redstoner-35/Xtern-Ripper-Lite/README.md

### 概述

这是由redstoner_35所开发的，基于FlashLightOS-Entry固件所开发的低成本32mm侧按全程降压恒流驱动。这款驱动相比强大的[Xtern-Ripper V3](https://github.com/redstoner-35/Xtern-Ripper)来说更为精简实用，且简化了操作逻辑，更适合于面向圈外人士使用的实用手电。且该驱动为单PCB设计，6mm的最大高度基本可以适配市面上大部分主流手电外壳。

### 关于FlashLightOS-Entry

FlashLightOS-Entry是面向低成本，较低性能的增强型8位8051单片机平台的FlashLightOS实现。相比运行在ARM平台的标准版FlashLightOS进行了更进一步的逻辑调整和优化降低性能和代码开销。该实现相比标准版FlashLightOS移除了几乎所有的挡位自定义和运行状态记录的功能，挡位逻辑硬编码于单片机的ROM内不可调整，也不需要外挂EEPROM作为系统的数据存储器。这使得该固件可以运行在32-48MHz主频的增强型8051单片机上，并且通过单片机片内EEPROM完成少量数据的存储从而最大限度的简化了驱动数字域部分的电路设计。

与此同时，得益于中微8bit平台的灵活性（数字IO可任意重映射）以及快速启动，本固件可进一步扩展为双模式尾按/侧按手电的版本，且外围电路可根据需要任意调整从而实现多种拓扑（单锂电升压/BUCK/4BB等）从而使得驱动使用可以更灵活。

### 驱动硬件结构

该驱动为了节约成本使用了现成的DC-DC芯片，并通过基于运放的外部恒流环路根据通过的LED电流，动态的调整DCDC芯片反馈引脚的电位从而调节输出电压实现恒流。对于LED辉度的控制，MCU则通过PWM+二阶RC滤波的方式为恒流环路提供设置输出电流的参考电压使LED运行在目标电流。与此同时，为了解决在低输出电流下检流部分的信噪比不足导致低亮度抖动，因此本驱动加入了LED电流的切换开关根据输出电流的范围动态选择电流通过的检流电阻确保在整个挡位的选择范围内信噪比足够。

### 工程结构

该工程一共有3个文件夹，分别对应2套PCB。文件格式为Altium Designer 15。可以用LCEDA导入后转换为LCEDA格式以便查看BOM和位号。各个PCB作用如下：

+ MainPCB：这个文件夹包含驱动的主板。
+ SideKeyPCB：这个文件夹包含配套使用的LED侧按按键板，通过细排线连接到驱动上层的子板。侧按板直径12mm，适配东东海D8B外壳。
+ Firmware：这个文件夹包含驱动的固件源代码

### PCB打样注意事项

+ `MainPCB`：1.6mm 4层板，默认层叠顺序（Top GND VCC Bottom）必须过孔塞树脂+沉金。内层必须加厚为1Oz，有条件建议上四层2Oz。
+ `SideKeyPCB`:1.0mm厚度双面板，铜厚1Oz喷锡即可。

### 调试说明

该驱动的设计为免调试的。只需要按照PCB上的丝印、器件位置和BOM表焊接好所有器件并为单片机刷入附带的[程序文件](/MainPCB/Firmware.hex)即可使用，不需要任何调试工作。对于驱动的成品图片可以参考下方：
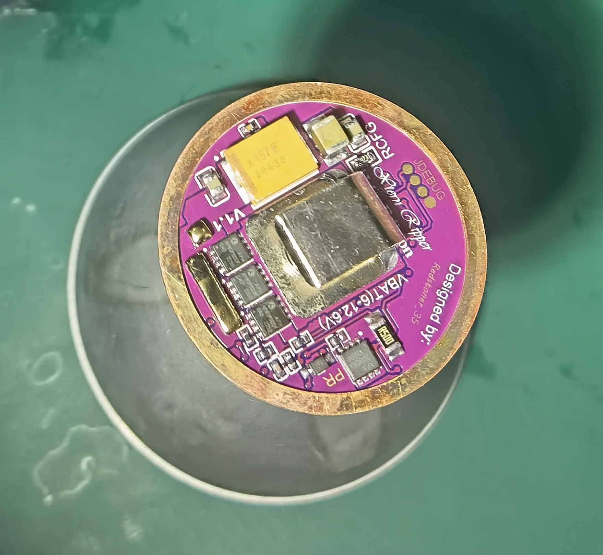
[picture p1: 成品图片/1.jpg]
背面

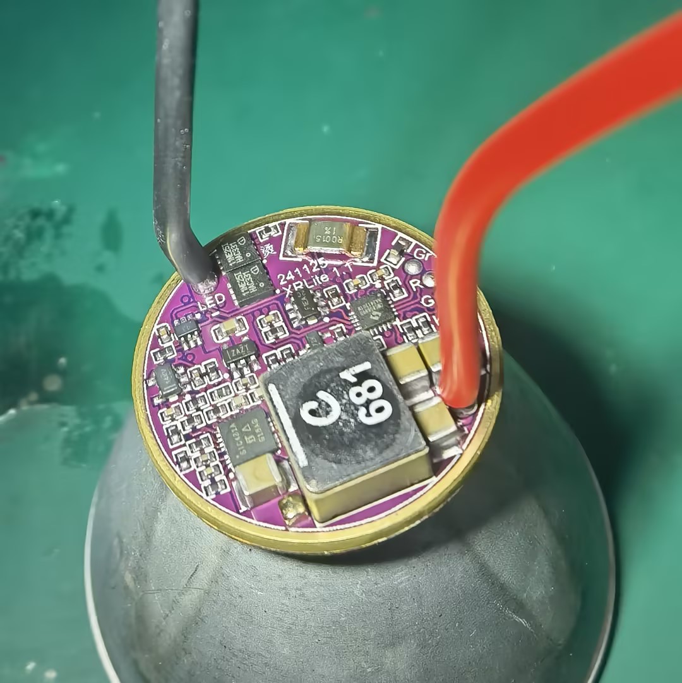
[picture p2: 成品图片/2.jpg]
正面


对于背面的装筒效果则如下图所示：

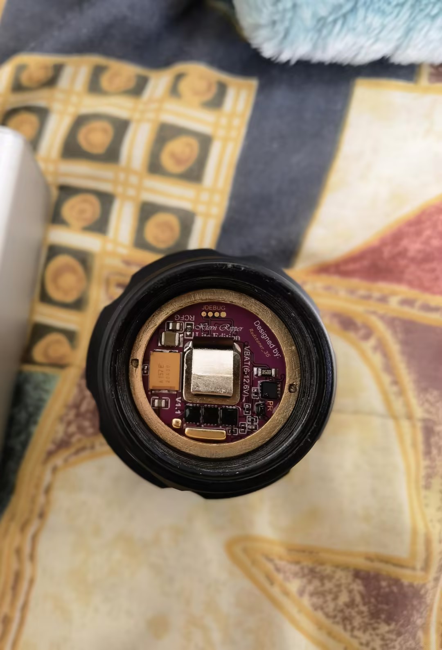
[picture p3: 成品图片/3.jpg]
装筒后背面


需要注意的是，如果您计划将该驱动用于仅具备侧部电子开关的外壳并且使用高内阻的容量型电池，则默认的固件程序因为内置的尾按监测机制会在爆闪等高瞬态的场合因电池内阻过大导致电压跌落至尾按监测阈值，引起爆闪SOS等挡位无法正常运行或者出现自动跳档。此时您需要刷入[禁用尾按监测功能的程序文件](/MainPCB/Firmware-ESwitch.hex)以解决部分挡位无法使用或者莫名其妙失控自动换挡等bug，此时配置电阻中关于尾按开关类型的设置机制将会被无视。

### 配置电阻设置

在V1.1版本中，驱动背面新增了一个标注为RCFG的0603电阻（见下图所示位置），用于配置驱动所支持的LED类型，极亮电流和电池串数，以及尾按开关的类型。驱动在每次上电时会自动读取该电阻的阻值并根据阻值设定参数。
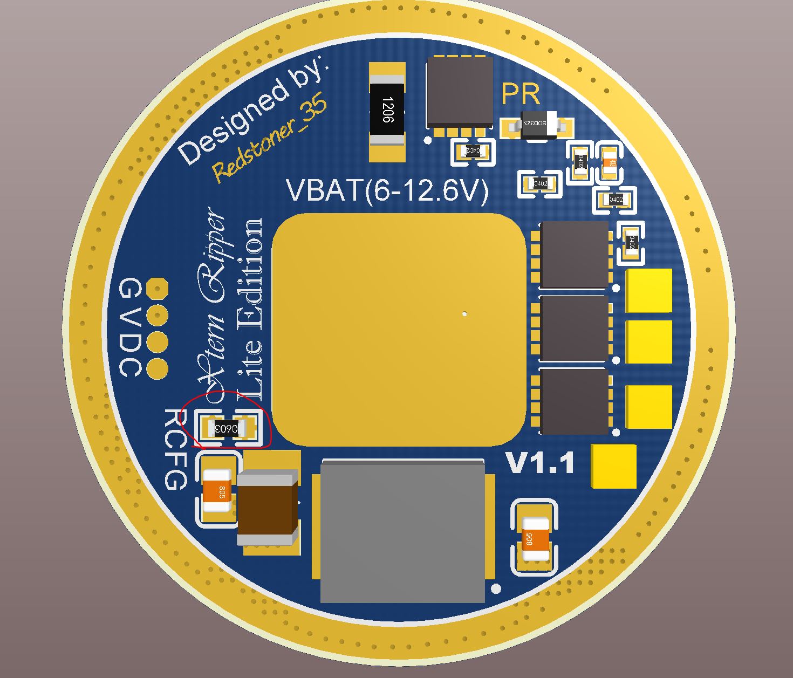
[picture p4: 成品图片/4.JPG]
配置电阻位置


#### 正向开关和反向机械尾按开关的区别

反向机械尾按开关和正向机械尾按开关适合于不同的用途，正向机械开关因为可以瞬时点亮的特性，更适合用于战术用途，但换挡操作较为不便。反向机械开关的换挡则更为方便但是缺乏正向机械开关的战术功能性，不支持无声点射（战术正向开关轻按点亮时不会发出声音）。这两者的区别如下：

+ 反向机械开关：关闭状态下需要重按到底发出咔哒声并松手后才能接通电路，处于开启状态下轻按开关则电路断开，松手后立马接通。如果再次重按到底发出咔哒声并松手则后开关断开，此时开关回到关闭状态。
+ 正向机械开关：关闭状态下轻按开关时即可接通电路，松手后立即断开。如果重按开关到底发出咔哒声后则电路保持接通（即使松手也不会断开）此时轻按开关电路仍然保持接通，只有再次重按到底发出咔哒声并松手后电路才会断开并回到关闭状态。

**注意：请严格按照使用的尾按类型选择配置电阻。如果配置电阻和尾按开关类型不匹配，则会出现开机存在延迟、尾按无法换挡或驱动工作异常等问题！如果您将本驱动用于没有尾部机械开关、只有侧部电子开关的场合，则请将驱动配置为反向机械开关的模式。**

#### 电阻阻值选择

**反向机械开关**

+ 182K：3串3.7V三元锂输入，6V LED，极亮14.5A（适用于DFEx-SuperLED+ QV7007I Gen1）
+ 174K：3串3.7V三元锂输入，6V LED，极亮18A（适用于DFEx-SuperLED+ FI1048D Gen1）
+ 168K：3串3.7V三元锂输入，6V LED，极亮10A（适用于SFQ75.3-6V or CREE XHP70.2 or CREE XHP70.3HI/HD）
+ 154K：3串3.7V三元锂输入，3V LED，极亮23A（适用于Luminus SBT90.2 or NBT160.2 or SFQ75.3）
+ 147K：2串3.7V三元锂输入，3V LED，极亮23A（适用于Luminus SBT90.2 or NBT160.2 or SFQ75.3）
+ 133K：2串3.7V三元锂输入，3V LED，极亮12A（适用于N5-235HP或者老批次SFT40 N5145冲刺极限光强）
+ 124K：2串3.7V三元锂输入，3V LED，极亮18A（适用于Luminus SBT90.2标准使用不超功率）
+ 113K：2串3.7V三元锂输入，3V LED，极亮10A（适用于N5-235HP标准使用不超功率）

**正向机械开关**

+ 82K：3串3.7V三元锂输入，6V LED，极亮14.5A（适用于DFEx-SuperLED+ QV7007I Gen1）
+ 75K：3串3.7V三元锂输入，6V LED，极亮18A（适用于DFEx-SuperLED+ FI1048D Gen1）
+ 68K：3串3.7V三元锂输入，6V LED，极亮10A（适用于SFQ75.3-6V or CREE XHP70.2 or CREE XHP70.3HI/HD）
+ 56K：3串3.7V三元锂输入，3V LED，极亮23A（适用于Luminus SBT90.2 or NBT160.2 or SFQ75.3）
+ 47K：2串3.7V三元锂输入，3V LED，极亮23A（适用于Luminus SBT90.2 or NBT160.2 or SFQ75.3）
+ 33K：2串3.7V三元锂输入，3V LED，极亮12A（适用于N5-235HP或者老批次SFT40 N5145冲刺极限光强）
+ 24K：2串3.7V三元锂输入，3V LED，极亮18A（适用于Luminus SBT90.2标准使用不超功率）
+ 15K：2串3.7V三元锂输入，3V LED，极亮10A（适用于N5-235HP标准使用不超功率）

**需要特别注意的是，配置电阻不能开路和短路，阻值需要在10K至200K之间并且按表选择，为了确保系统能正确识别配置，请选择至少1%精度并且温飘在50PPM以下的0603精密电阻作为配置电阻。如果该电阻阻值不合适或者空焊，驱动将会拒绝启动并报错。为了避免驱动的低电压保护失效引起电池损坏或者错误的提示LED发生故障，请严格按照实际的硬件情况选取该配置电阻的阻值。**

### 侧按换挡和配置操作逻辑

该驱动具备无极调光和传统挡位模式两种逻辑供用户自由选择：
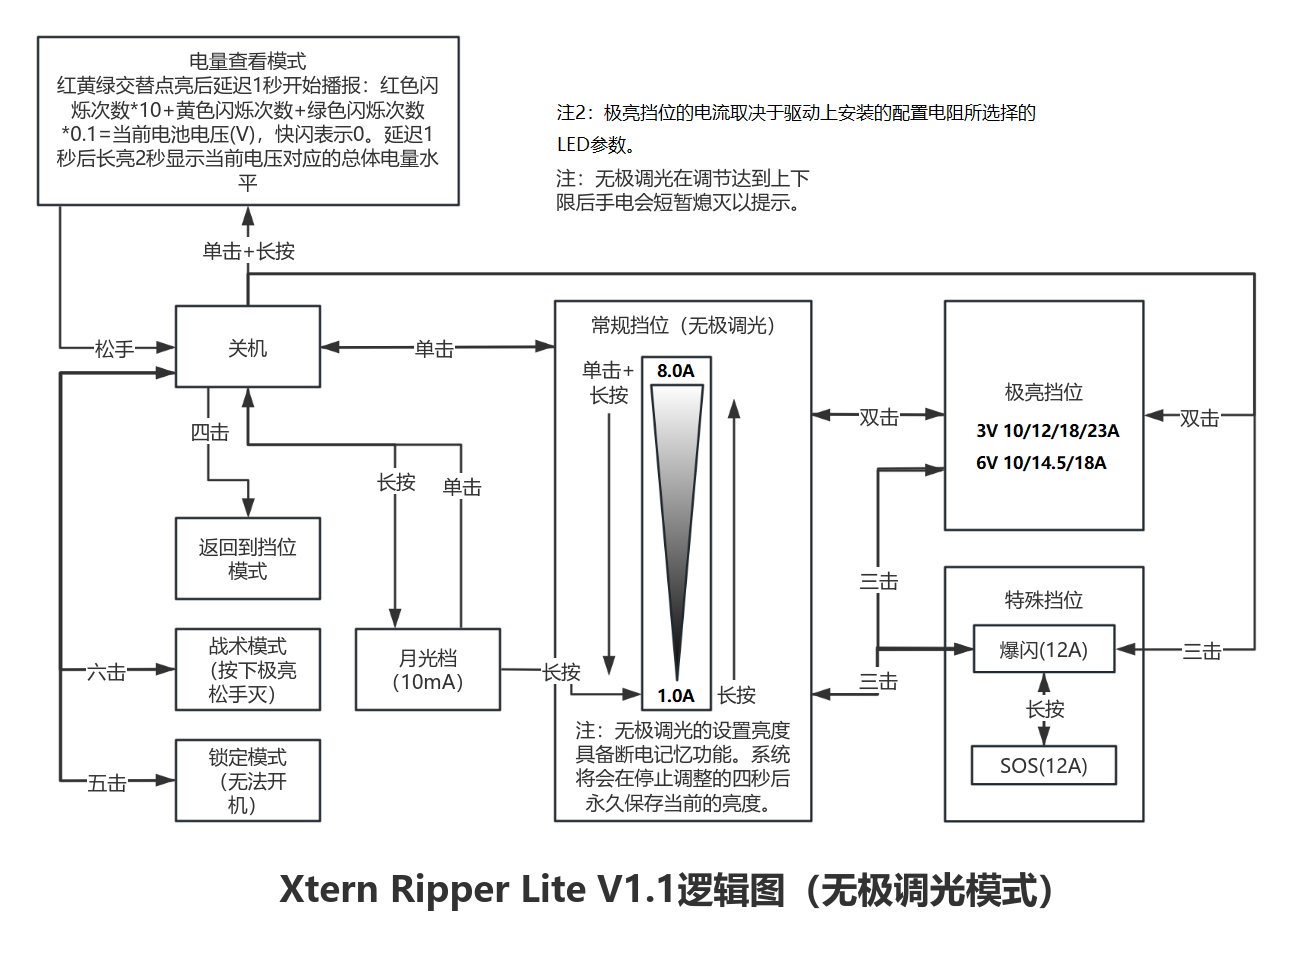
[picture p5: 成品图片/Ramp.png]
无极调光

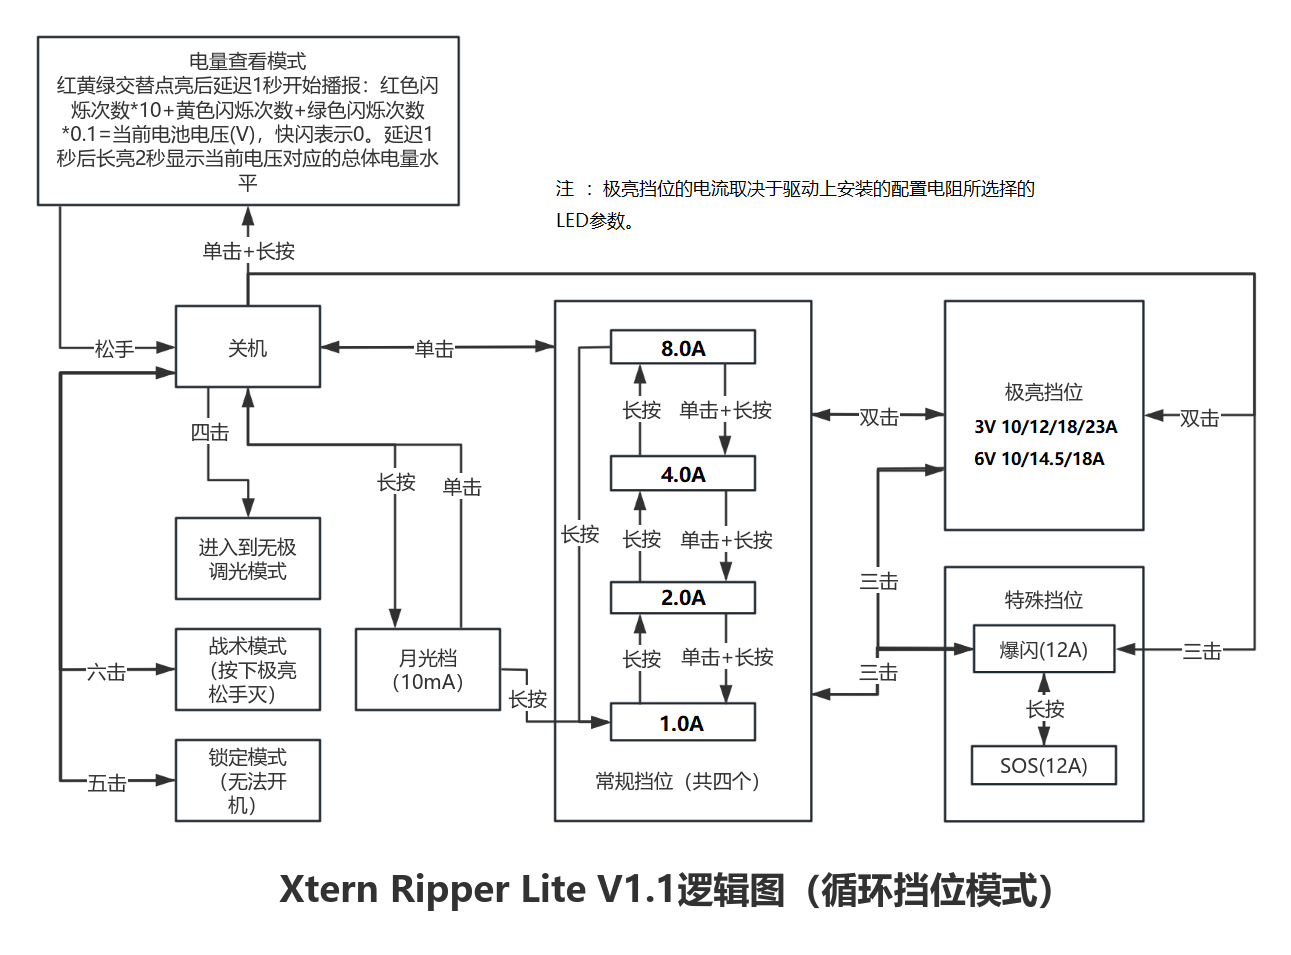
[picture p6: 成品图片/Mode.png]
挡位模式


需要补充的是，图中的任意挡位均可以通过单击立即回到关闭状态。对于图中的部分未详尽解释的特殊逻辑，则可参考如下内容：

+ 切换无极调光和挡位模式：关机状态下四击开关，此时开关指示灯将会闪烁三次。如果闪烁颜色为红色则无极调光已被关闭，绿色则为开启。
+ 战术模式：关机状态下六击开关，手电主灯迅速频闪一次表示进入战术模式。默认情况下战术功能为按下开关手电以极亮运行，松开则熄灭。当手电进入战术模式后，侧部按键将会每2秒快闪一次指示当前处于战术模式，此时手电将会保持唤醒，直到无操作10分钟后自动进入休眠并退出战术模式。与此同时，您可以通过双击侧按切换战术模式的功能，切换后的指示如下：
    + 一键极亮模式（默认）：此时手电按下开关极亮，松开灭，侧按指示灯每2秒闪1次，切换到该模式时手电的侧按会用红色快闪3次做提示。
    + 一键爆闪模式：此时手电按下开关进入爆闪，松开灭，侧按指示灯每2秒闪2次，切换到该模式时手电的侧按会用绿色快闪3次做提示。
如果您需要主动退出战术模式，则您可再度六击开关，手电主灯频闪一次指示退出战术模式。
+ 按键锁：关机状态下五击开关，手电主灯点亮0.5秒表示进入锁定模式，此时除五击解锁外的任何操作均被忽略。
+ 查询电量：进入操作和逻辑中的一致（如果手电处于开机状态，则通过双击+长按进入）。当进入电量查询模式后手电首先以红黄绿依次点亮的方式提示用户即将显示电量。如果电池电压在合法范围内，则在延迟1秒后手电将通过红色，黄色和绿色的指定次数闪烁提示用户当前的电池电压。如果电池电压超出显示范围（例如2串模式的驱动意外接入3串的锂电池组）则驱动会通过三次红色闪烁提示电压非法。对于电池电压的显示方式则会根据驱动的配置电阻所指定的电池串数自动选择。如果驱动配置为三串输入的时候，系统的显示方式将会被设置为99.9V模式，2串模式则驱动会自动配置为9.99V模式显示以提高电压显示精度。对于电压显示的计算方式请参考如下内容：
    + 99.9V显示模式：红色闪烁次数x10+黄色闪烁次数+绿色闪烁次数x0.1=当前电池电压(V)，例如`红色慢闪1次-黄色快闪一次-绿色慢闪4次`表示电池电压为10x1+0+4x0.1=10.4V。
    + 9.99V显示模式：红色闪烁次数+黄色闪烁次数*0.1+绿色闪烁次数x0.01=当前电池电压(V)，例如`红色慢闪8次-黄色快闪一次-绿色慢闪4次`表示电池电压为8+0x0.1+4x0.01=8.04V。

**注：以上内容中的慢闪指的是持续0.5秒的点亮和持续0.5秒的熄灭交替循环的过程。快闪则是瞬间点亮20mS后熄灭（人眼视觉效果为非常迅速的跳一下）**

播报完电池当前电压后，手电将会在延迟2秒后通过后续的长亮(或者慢闪)提示用户当前电池电压对应的总体电量水平（指示方式参考下文中驱动位于运行状态时的指示）

对于电压指示，驱动在工作状态会通过指示灯点亮的方式提示用户当前系统的电池电量。与此同时，在手电首次装入电池时，驱动还会通过多次黄色快速闪烁指示用户通过配置电阻设置的电池串数（如果闪烁2次则驱动为2串模式，闪烁3次则为三串模式）并且在电池数量指示结束后用一次持续2秒的点亮提示电池电量（指示方式和工作状态时相同）。对于手电当前的电量状态和对应的指示灯状态请参考如下内容：

+ 绿色常亮：电池电量充足
+ 黄色常亮：电池电量较为充足
+ 红色常亮：电池电量不足，请尽快为手电充电
+ 红色慢闪：电池电量严重不足，请立即为手电充电（此时手电的可用挡位和功能将会被限制）

### 错误指示系统

该驱动继承了Xtern Ripper PRO版本的特性，依然具备先进的状态监测系统。在驱动每次通电自检和正常运行过程中，固件会通过ADC采集驱动的运行状态并判断负载和驱动是否运行正常。并且在检测到异常时立即切断驱动输出以避免驱动和被驱动的灯珠损坏。

#### 运行时错误监测和错误ID汇报

在运行期间如果驱动检测到无法解决的致命问题则会进入保护模式避免驱动和灯珠损毁，并通过颈部侧按键的指示灯提示用户发生的错误类型。每个指示循环首先以红黄绿的颜色切换闪烁开始，然后通过紧跟着的红色慢闪次数指示错误ID号，慢闪结束后会停顿一会并重新开始循环，对于ID号所对应的错误描述请参考如下内容：

+ 闪烁1次(Fault_DCDCFailedToStart) 驱动在上电自检尝试启动DCDC时失败。检查驱动输出正极是否对外壳短路，DCDC芯片的使能信号和内部LDO输出电压是否正常。
+ 闪烁2次(Fault_DCDCENOOC) 驱动在上电自检时无法关闭DCDC。检查单片机控制DCDC EN电源的输出是否能正确关闭，EN是否受控。
+ 闪烁3次(Fault_DCDCShort) 驱动在运行时检测到输出短路。
+ 闪烁4次(Fault_InputOVP) 驱动检测到输入电压过高，请检测驱动的电池配置是否和使用的电池配套。
+ 闪烁5次(Fault_DCDCOpen) 驱动在运行时检测到输出空载，检查LED是否损坏。
+ 闪烁6次(Fault_NTCFailed) 驱动在运行期间检测到测量驱动温度的热敏电阻出现异常，检查热敏电阻和测温部分的上拉电阻是否损坏。
+ 闪烁7次(Fault_OverHeat) 驱动检测到外壳温度过高，请等待手电冷却。冷却后故障会自动解除
+ 闪烁8次(Fault_StrapResistorError) 驱动检测到配置电阻未焊接（开路）或阻值过低。请按照配置电阻设置的章节正确焊接电阻并检查电阻是否损坏。
+ 闪烁9次(Fault_StrapMismatch) 配置电阻所指定的LED类型和驱动实际检测到的类型不符，请按照配置电阻设置的章节正确选取阻值。

### 尾按换挡操作逻辑

对于使用东东海D4GC-M4A-D5E等外壳的用户，本驱动提供了双模式换挡固件供用户尝试。该固件除了支持原版固件通过颈部电子开关换挡的功能以外，还支持使用手电外壳的尾部机械开关通过断电的方式进行快捷换挡。同时该固件可支持正向机械尾按开关实现战术点射（需要通过配置电阻选择），换挡方式如下：

#### 反向开关操作逻辑

**特别注意：如果用户通过侧部开关令手电进入关闭状态，则尾部开关换挡功能将被禁用。此时按压尾部开关则无法换挡**

+ 手电开启且处于传统挡位模式下，用户轻按尾按后手电按照从低到高(`1A->2A->4A->8A->->月光->1A...`)再回到月光并从低亮开始反复循环的方式换挡，快速轻按2次则进入极亮档，快速轻按3次则进入爆闪挡位，单击在SOS和爆闪挡位之间循环。如果需要关机，则重按尾按到底听到咔哒声后松手即可关闭。通过尾按关闭手电后下次再重按尾按打开手电后，手电会回到上次关闭之前的挡位继续运行（如果上次关机前挡位为特殊挡位则会回到低亮档）
+ 手电开启且处于无极调光模式下，用户可通过轻按尾按一次进行亮度调整。轻按尾按后手电亮度将会开始从低到高，再到低亮反复变化。当手电亮度达到您的需求后，再次轻按尾按后手电将会保存亮度。快速轻按2次则进入极亮档，快速轻按3次则进入爆闪挡位，单击在SOS和爆闪挡位之间循环，在非爆闪/极亮和SOS等特殊挡位下，快速轻按4次则进入月光档。如果需要关机，则重按尾按到底听到咔哒声后松手即可关闭。通过尾按关闭手电后下次再重按尾按打开手电后，手电会回到上次关闭之前的亮度继续运行（如果上次关机前挡位为特殊挡位则会回到常亮挡位）

#### 正向开关操作逻辑

**对于正向开关而言，操作逻辑中所说的轻按为半按开关至手电上电。重按则是直接按到底进入锁定发出咔哒声。对于操作逻辑中的轻按开关一下指按下开关一瞬间，然后立即放开。**

+ 强制打开通过侧按按键关闭的手电：轻按尾按开关一下并按到底，手电将直接开机。
+ 点射：轻按尾按开关按照上次关机前记忆的挡位（或者无极调光模式下记忆的亮度）点亮，松开熄灭
+ 挡位模式选择下一个挡位：轻按尾按开关一下再轻按并保持，此时手电将会点亮。当手电点亮3秒后记忆当前挡位，此时您可以放开开关以关闭手电，下次轻按开关点射时将会按照您设定的亮度点亮。如果您需要继续换挡，则在保持3秒后放开尾按开关并重复本操作。对于换挡流程，手电则按照从低到高(`1A->2A->4A->8A->->月光->1A...`)再回到月光并从低亮开始反复循环的方式换挡。
+ 无极调光模式下调节亮度：轻按尾按开关一下再轻按并保持。此时手电将会点亮并且亮度再无极调光上限和下限之间反复循环，当手电达到你满意的亮度后松开开关并再次重按到底此时手电将会保存您所选择的亮度，此时您可以再次重按开关以关闭手电，下次轻按开关点射时将会按照您设定的亮度点亮。
+ 快速进入极亮：轻按尾按开关两次后再持续轻按（如果您需要松手后持续点亮则重按开关），手电立即以极亮模式点亮。开关松手后熄灭（注意：极亮模式没有记忆，下次轻按尾按打开手电后会返回低亮档）。
+ 快速进入爆闪：轻按尾按开关三次后再持续保持轻按（如果您需要松手后持续点亮则重按开关），手电立即以爆闪模式点亮。开关松手后熄灭（注意：爆闪模式没有记忆，下次轻按尾按打开手电后会返回低亮档）。
+ 进入SOS模式：轻按尾按开关三次后再持续保持轻按，此时手电将点亮并以爆闪模式工作。在手电进入爆闪模式开始工作时的1秒后，松开手电开关并在瞬间再次重按到底，此时手电进入SOS模式（注意：SOS模式没有记忆，关闭手电后，下次轻按尾按打开手电后会返回低亮档）
+ 无级调光模式下进入月光档：轻按尾按开关四次后再持续保持轻按（如果您需要松手后持续点亮则重按开关），手电点亮并以月光模式运行。

### 固件编译注意事项

#### MCU的CONFIG配置

由于中微单片机内部有一组硬编码于Flash指定区域，用于设置单片机的硬件首选项（例如看门狗，调试模式，低电压保护点等）的配置Word。为了确保编译出来的固件可以在硬件内正常运行，您需要在工程配置(Options for Target 'XRLite'->Debug选项卡->右上角的Settings按钮)的Config设置菜单，按照下表正确填写MCU的配置。错误的CONFIG设置会引起固件工作异常！

+ Power                      :  Inter 5V            
+ WDT                        :  SOFTWARECONTROL     
+ PROTECT                    :  ENABLE              
+ FLASH_DATA_PROTECT         :  ENABLE              
+ LVR                        :  1.8V                
+ DEBUG                      :  Disable             
+ OSC                        :  HSI                 
+ OSC_PRESCALE               :  Fosc/1              
+ HSI_FS                     :  Fhsi/1              
+ EXT_RESET                  :  DISABLE             
+ EXT_RESETSEL               :  P00                 
+ WAKEUP_WAITTIME            :  100us               
+ CPU_WAITCLOCK              :  1T                  
+ WRITE_PROTECT[0-2K]        :  DISABLE             
+ WRITE_PROTECT[2-4K]        :  DISABLE             
+ WRITE_PROTECT[4-6K]        :  DISABLE             
+ WRITE_PROTECT[6-8K]        :  DISABLE             
+ WRITE_PROTECT[8-10K]       :  DISABLE             
+ WRITE_PROTECT[10-12K]      :  DISABLE             
+ WRITE_PROTECT[12-14K]      :  DISABLE             
+ WRITE_PROTECT[14-16K]      :  DISABLE             
+ BOOT                       :  BOOT_DIS            

#### 代码内非语法错误的提示

为了确保用户不会错误的填写部分关键数值（例如温控系统的配置参数）导致固件行为异常，本固件源码内包含一些条件编译的监测代码用于监测非法数值。如果编译时遇到了非语法错误的输出，可以在这里查询相应的错误并进行修正。

+ `Error 001:Invalid Integral Configuration,Trim Value or time-factor out of range!`: 积分器的时间常数和电流修调值决定了积分器的上限，由于积分器所使用的变量为int 16，其值域为-32767到32767。如果积分器上限超过了值域则会导致数值溢出引起程序异常。此时您需要减小电流修调值和时间常数确保两者之积不大于32000。
+ `Error 002:Invalid Integral Configuration,Trim Value or time-factor must not be zero or less than zero!`: 积分器的时间常数和电流修调值决定了积分器的上限，为了确保积分器能正常运行，积分器的上限值不能为0或者负数，请检查填入的数值是否包含负数和0。
+ `Error 003:Emergency Shutdown Temp must not exceeded 85 Celsius!` : 紧急关机温度太高了，不能超过85度
+ `Error 004:Force Disble Turbo Temp must less than Emergency Shutdown Temp for at least 15 Celsius!` :
+ `Error 005:Force Disble Turbo Temp must higher than Constant Temp of Turbo Mode for at least 8 Celsius!`: 强制禁用极亮挡位的温控值应该比紧急关机温度低15度以上，且至少高于极亮恒温温度8度
+ `Error 006:Constant Temperature of Turbo Mode must lagger than Constant Temperature of other mode!`:
+ `Error 007:Constant Temperature of other mode must lagger than Thermal Control Release Temp for 5 Celsius!`: 非极亮挡位的温控恒温温度必须要比极亮挡位的温控数值小，且至少比温控停止的阈值高5度确保温控的稳定运行。
+ `Error 008:Thermal Control Release Temp is too low and will not release at summer!`: PI环的温控释放点太低，在夏天因为手电自发热可能导致温控始终激活，即使通过外力给手电降温也无法正确退出。

----------------------------------------------------------------------------------------------------------------------------------
© redstoner_35 @ 35's Embedded Systems Inc.  2024
