redstoner-35/Xtern-Ripper-Lite/MainPCB/BOM.xlsx

编号 | 料号 | 描述 | 位号 | 封装 | 数量 | 备注 | 单价 | 总价
1 | TCN4107M035R0100E | 京瓷/AVX 贴片聚合物钽电容器 35V 100uF ±20% 2924 ESR=100mΩ | C1 | TCN4 | 1 | 这玩意单价不便宜，封装特殊小心买到假的。2串三元锂电输入的时候可以TCN4157M025R0070E替代 | 12 | 12
2 | EMK325ABJ107MM-T | 1210尺寸多层陶瓷电容器(MLCC) X5R材质，16V 100uF±20% | C2, C3, C4, C5, C6 | 1210C | 5 | 此处提供的为太诱的料号，可用AVX/村田和国巨的相似参数电容进行替代 | 1.8 | 9
3 | 22uF (226) 20% 25V | 0805贴片电容 | C7, C10 | 0805_C | 2 |  | 0.1 | 0.2
4 | 220nF (224) 10% 16V | 0402贴片电容 | C8 | 0402_C | 1 |  | 0.03 | 0.03
5 | 100nF (104) 10% 16V | 0402贴片电容 | C9, C14, C15, C20 | 0402_C | 4 |  | 0.03 | 0.12
6 | 4.7uF (475) 20% 10V | 0402贴片电容 | C11, C12 | 0402_C | 2 |  | 0.03 | 0.06
7 | 47nF (473) 10% 50V | 0402贴片电容 | C13 | 0402_C | 1 |  | 0.03 | 0.03
8 | 1.0uF (105) 10% 25V | 0402贴片电容 | C16 | 0402_C | 1 |  | 0.03 | 0.03
9 | 10uF (106) 10% 10V | 0402贴片电容 | C17 | 0603_C | 1 |  | 0.03 | 0.03
10 | 10nF (103) 10% 50V | 0402贴片电容 | C18 | 0402_C | 1 |  | 0.03 | 0.03
11 | 470nF (474) 10% 10V | 0402贴片电容 | C19 | 0402_C | 1 |  | 0.03 | 0.03
12 | 1nF (102) 10% 50V | 0402贴片电容 | C21 | 0402_C | 1 |  | 0.03 | 0.03
13 | 1N4148WS T4 | 二极管 | D1 | SOD-323 | 1 |  | 0.08 | 0.08
14 | BZT52C3V9S W5 | SOD-323封装贴片稳压二极管， 3.9V 200mW | D2 | SOD-323 | 1 |  | 0.095 | 0.095
15 | EBMS100505A050 | 贴片磁珠 200mA 5R±25% 100MHz | FB1 | 0402_L | 1 |  | 0.018 | 0.018
16 | XAL1060-681MEB | 线艺XAL系列模压屏蔽贴片电感 680nH±20% 10*10*6mm尺寸 DCR：2.50mΩ 饱和电流43A | L1 | XAL1010-XXXME | 1 |  | 30 | 30
17 | AP80P02DF | 永源微 PDFN3x3-8L -20V -80A 4.0mΩ P沟道MOSFET | Q1, Q2, Q3 | DFN-8_L3.0-W3.0-P0.65-BL | 3 |  | 0.65 | 1.95
18 | BSZ011NE2LS5IATMA1 | PDFN3x3 37nC 25V 40A 1.1mΩ OptiMOS-5 N沟道MOSFET | Q4, Q5 | DFN-8_L3.0-W3.0-P0.65-BL | 2 |  | 4.5 | 9
19 | BSZ050N03MSG | PDFN3x3 30V 45A 4.6mΩ OptiMOS-3 N沟道MOSFET | Q6 | DFN-8_L3.0-W3.0-P0.65-BL | 1 |  | 1.5 | 1.5
20 | 2N7002KW | 单N沟道MOSFET(场效应管) | Q7 | SC70-3 | 1 |  | 0.2 | 0.2
21 | DMG6601LVT-7 | SOT23-6封装复合N+P沟道MOSFET | Q11 | SOT95P245X110-6N | 1 |  | 0.35 | 0.35
22 | 20KΩ (2002) ±1% | 0402贴片电阻 | R1, R24 | 0402_R | 2 |  | 0.012 | 0.024
23 | 0Ω (0R0) ±1% | 0402贴片电阻 | R2 | 0402_R | 1 |  | 0.012 | 0.012
24 | 100KΩ (1003) ±1% | 0402贴片电阻 | R4, R18, R22, R23 | 0402_R | 4 |  | 0.012 | 0.048
25 | 10KΩ (1002) ±1% | 0402贴片电阻 | R5, R9, R11, R16, R25, R28 | 0402_R | 6 |  | 0.012 | 0.072
26 | 11KΩ (1002) ±1% | 0402贴片电阻 | R6 | 0402_R | 1 |  | 0.012 | 0.012
27 | 110KΩ (1103) ±1% | 0402贴片电阻 | R7 | 0402_R | 1 |  | 0.012 | 0.012
28 | ASR-M-3-R0015-1.0 | 深圳华讯高科精密检流电阻，2512 1.5mΩ±1% 卡玛材质 <50ppm/K P70℃=3W | R8 | 2512 | 1 |  | 0.78 | 0.78
29 | RL12FTNR500 | 1206厚膜采样电阻 0.5Ω ±1% 1/2W | R10 | 1206R | 1 |  | 0.2 | 0.2
30 | 10MΩ (1005) ±1% | 0402贴片电阻 | R12 | 0402_R | 1 |  | 0.012 | 0.012
31 | 100Ω (1000) ±1% | 0402贴片电阻 | R14, R17 | 0402_R | 2 |  | 0.012 | 0.024
32 | 1.5KΩ (1501) ±1% | 0402贴片电阻 | R19 | 0402_R | 1 |  | 0.012 | 0.012
33 | 680K (6803) ±1% | 0402贴片电阻 | R20 | 0402_R | 1 |  | 0.012 | 0.012
34 | 470KΩ (4703) ±1% | 0402贴片电阻 | R21 | 0402_R | 1 |  | 0.012 | 0.012
35 | 330KΩ (3303) ±1% | 0402贴片电阻 | R26 | 0402_R | 1 |  | 0.012 | 0.012
36 | SDNT1608X104F4250FTF | 0603贴片NTC热敏电阻， 100KΩ (1003) ±1% B4250 | R27 | 0603_R | 1 |  | 0.14 | 0.14
37 | SIC431AED-T1-GE3 | 3 to 24V Input 24A MicroBuck DCDC Converter with bulit-in MOSFET | U1 | QFN_ED-T1-GE3_VIS | 1 | 不能用SIC431BED-T1-GE3替代，会导致低亮度挡位出现严重闪烁和啸叫 | 6.58 | 6.58
38 | TLV333IDBVR | 低噪声轨到轨输入输出精密单运放 350Khz带宽 单电源5V供电 | U2 | SOT95P245X110-5N | 1 |  | 1.45 | 1.45
39 | CH443K | 低导通内阻单刀双掷模拟开关 1.8-5V供电电压 SOT363/SC70-6封装 | U3 | SC70-6 | 1 | 国外用户不好采购可以用 ON-SEMI的NC7SB3157P6X进行替代 | 0.3 | 0.3
40 | TPS7B6950DBVR | 150mA 40V max input Ultra low Iq LDO,fixed 5V output | U4 | SOT95P245X110-5N | 1 |  | 1.15 | 1.15
41 | CMS8S6990NAQN20 | 中微增强型闪存1T 8051单片机， 16KB Flash 256+1K XRAM，QFN-20封装 | U5 | QFN-20-3x3 | 1 | 不能用CMS8S6990QN20 替代 | 1.1 | 1.1
42 | ??KΩ ±1% | 0603贴片电阻 | R15 | 0603_R | 1 | R15为驱动参数配置电阻，请根据手电装机所使用的电池节数、LED类型、极亮电流选择阻值。 | 0.2 | 0.2
43 | 91KΩ (9102) ±1% | 0402贴片电阻 | R13 | 0402_R | 1 |  | 0.012 | 0.012
44 | 200KΩ (2003) ±1% | 0402贴片电阻 | R29 | 0402_R | 2 |  | 0.012 | 0.024
45 | 499KΩ (4993) ±1% | 0402贴片电阻 | R3 | 0402_R | 2 |  | 0.012 | 0.024
46 | CC1206MKX5R6BB476 | 1206 MLCC电容 10V 47uF±20% X5R | C23 | 1206C | 1 |  | 0.5 | 0.5
合计总价 |  |  |  |  |  |  | 77.507
 |  | 1
