redstoner-35/Xtern-Ripper-Lite/MainPCB/Schematic.pdf

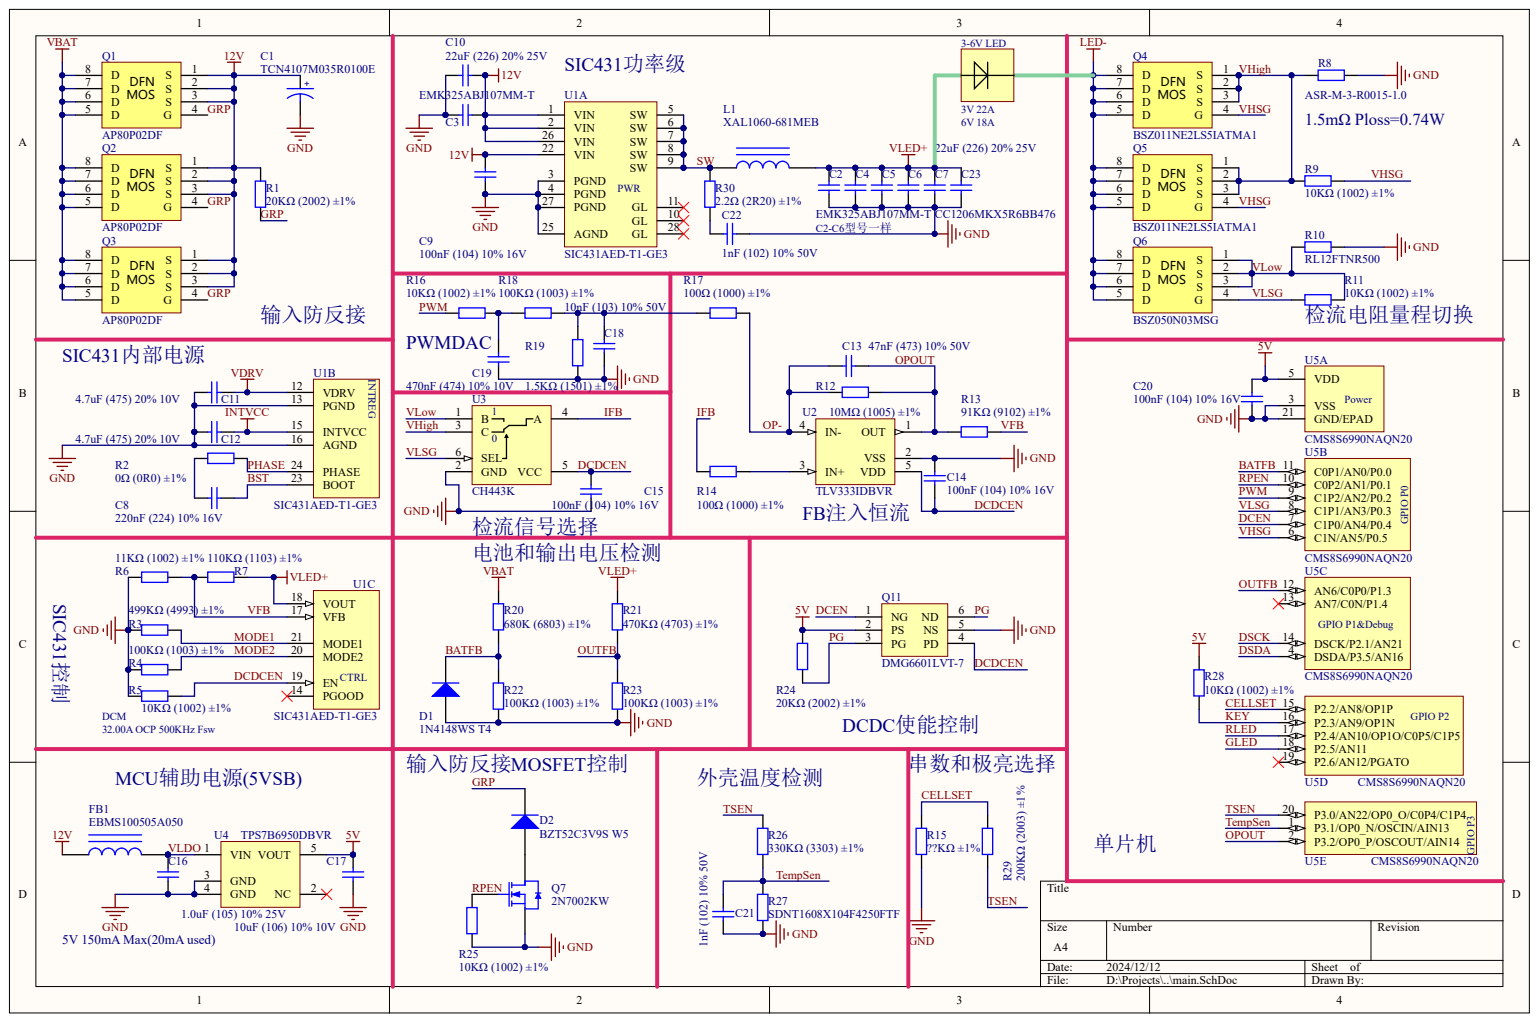
[picture p7: page 1]
