redstoner-35/Xtern-Ripper-Lite/(list of files, drawings)

Other design files:
MainPCB/main.SchDoc
MainPCB/PCB1.PcbDoc
MainPCB/Xtern-Ripper Lite.PrjPcb
SideKeyPCB/main.SchDoc
SideKeyPCB/PCB3.PcbDoc
SideKeyPCB/驱动侧按按键板.PrjPcb
