redstoner-35/Xtern-Ripper-Lite/Firmware/Hardware/ADCCfg.c

#include "cms8s6990.h"
#include "PinDefs.h"
#include "ADCCfg.h"
#include "ADCAsync.h"
#include "delay.h"

/**********************************************************************
以下函数为ADC异步转换引擎实现功能所需的内部处理函数以及所需的内部全局变
量。请不要随意修改函数内容，或者在除了本文件内的其他任何地方调用，否则
会导致ADC引擎工作异常！	
**********************************************************************/
static xdata ADCConvertTemp ADCTemp;
static ADCAsyncStateDef ADCState;	
static xdata char ADCConvertQueue[ADCConvertQueueDepth];	
xdata bool IsNotAllowAsync;	 //是否允许ADC引擎运行在异步模式
	
//向ADC提交任务	
static void ADC_SubmitMisson(char Ch)	
	{
	unsigned char i=255;
	//检查传入的通道参数是否合法
	if(ADCTemp.IsMissionProcessing)return;
	if(ADC_CheckIfChInvalid(Ch))return; 
	//进行初始化
	ADCTemp.avgbuf=0;
	ADCTemp.Count=0;
	ADCTemp.Ch=Ch;
	ADCTemp.IsMissionProcessing=true;
	//配置ADC通道		
	if(Ch&0x10)ADCON0|=0x80;
	else ADCON0&=0x7F; //设置ADCHS[4]
	ADCON1&=0xF0;
	ADCON1|=(Ch&0x0F); //设置ADCHS[3:0]					
	//启动转换
	while(--i);  //延时等待通道选通后开始采样
	ADC_StartConv();
	}	

//读取数据
static int ADC_ReadBackResult(int *Result,char *Queue)	
	{
	//ADC未完成本次转换
	if(ADC_GetIfStillConv())return 0; 
	//收取结果
	ADCTemp.Count++; //数值+1
	ADCTemp.avgbuf+=(long)ADC_ReadConvResult(); //从AD寄存器收取结果并进行平均累加
	if(ADCTemp.Count<ADCAverageCount) 
		{
		ADC_StartConv();
		return 0;//平均次数未到，重新启动ADC进行新一轮的处理
		}
	//完成转换，返回结果并准备可以提交新的任务
	ADCTemp.avgbuf/=(long)ADCAverageCount;
	*Result=(int)ADCTemp.avgbuf; //返回结果
	*Queue=ADCTemp.Ch; //返回转换的队列
	ADCTemp.IsMissionProcessing=false; //任务已处理完毕
  return 1;	
	}

//ADC设置电压参考	
static void ADC_SetVREF(bit IsUsingVDD)
	{
	ADC_DisableCmd(); //转换ADC基准需要暂时关闭ADC	
	_nop_();
	ADC_SetVREFReg(IsUsingVDD); //设置芯片内部基准
	_nop_();
	ADC_EnableCmd(); //基准切换完毕，重新启动
	}
//转换完毕后写输出引擎
int	CalcNTCTemp(bool *IsNTCOK,unsigned long NTCRes); //函数声明		

static void ADC_WriteOutputBuf(int ADCResult,char Ch)
	{
	float Buf,Rt,Vadc;
	unsigned long NTCRES;
	extern xdata char VbattCellCount;	
	//进行ADC
	Rt=ADC_IsUsingIVREF()?ADCVREF:Data.MCUVDD; //根据基准设置得到AD当前的基准电压
	Vadc=(float)ADCResult*(Rt/(float)4096);//将AD值转换为原始电压
	//状态机
  switch(Ch)
		{
		//计算FB注入运放的输出电压
		case OPFBAIN:
			Data.FBInjectVolt=Vadc; 
		  break;
		//计算参考电压
		case ADC_INTVREFCh:
			Buf=ADCBGVREF*(float)4096/(float)ADCResult;
			Data.MCUVDD=Buf; //计算出MCUVDD(VREF)
		  break; 
		//计算电池电压
		case VBATInputAIN:
			Buf=(float)VBattLowerResK/(float)(VBattLowerResK+VBattUpperResK);//计算出分压电阻的系数
			Data.RawBattVolt=Vadc/Buf; //根据分压系数反推出电池电压
		  Data.BatteryVoltage=Data.RawBattVolt/(float)VbattCellCount; //将3节电池的总电压转换为单节电池的电压
		  break;
	  //计算输出电压
		case VOUTFBAIN:		
			Buf=(float)VoutLowerResK/(float)(VoutLowerResK+VoutUpperResK);//计算出分压电阻的系数
			Data.OutputVoltage=Vadc/Buf; //根据分压系数反推出DCDC输出电压
			Buf=(Data.OutputVoltage/Data.RawBattVolt)*100; //计算输入输出压差
		  Data.VOUTRatio=(char)Buf;
		  if(Data.VOUTRatio>100)Data.VOUTRatio=100;
	    if(Data.VOUTRatio<0)Data.VOUTRatio=0; //计算百分比并限幅
		  break;
	  //计算配置电阻阻值
		case BATTSELAIN:
			Rt=((float)VStrapUpperResValueK*Vadc)/(Data.MCUVDD-Vadc);//得到配置电阻阻值
			Data.CfgStrapRes=(int)Rt; //将计算出的阻值(KΩ)转换为整数
    //计算温度
		case NTCInputAIN:
			Rt=((float)NTCUpperResValueK*Vadc)/(Data.MCUVDD-Vadc);//得到NTC+单片机IO导通电阻的传感器阻值
			Rt*=1000; //将阻值从K欧转为Ω
			NTCRES=(unsigned long)Rt; //取整
			Data.Systemp=CalcNTCTemp(&Data.IsNTCOK,NTCRES); //计算温度
			break;
		}
  }

//ADC异步引擎的主处理函数
static void ADCEngineHandler(void)
	{
	int result;
	char Ch,i;
	//转换循环
  do
		{
		if(ADCState==ADC_ConvertComplete)ADCState=ADC_SubmitQueue; //如果一轮转换完成则重新开始
		switch(ADCState)
			{		
			//开始提交转换队列
			case ADC_SubmitQueue: 
				ADC_SetVREF(1); //每次提交队列之前，设置基准使用MCUVDD来转换温度和MCUVDD电压
				for(i=0;i<ADCConvertQueueDepth;i++)ADCConvertQueue[i]=ADCChQueue[i]; //把转换队列里面的数据复制过去
			  ADCState=ADC_SubmitChFromQueue;
			  break;
		  //向ADC转换线程提交任务
			case ADC_SubmitChFromQueue: 
			  i=0;
			  while(i<ADCConvertQueueDepth)
					{
					if(!ADC_CheckIfChInvalid(ADCConvertQueue[i]))break; //找到队列中未完成的合法转换项目
					i++;
					}
				//有转换项目未完成
				if(i<ADCConvertQueueDepth)	
					{
					Ch=ADCConvertQueue[i]; //检测目标的通道值
          if(Ch==VBATInputAIN||Ch==VOUTFBAIN)ADC_SetVREF(0); //电池和输出电压转换使用内部精密通道
					ADC_SubmitMisson(Ch); //提交项目
					ADCState=ADC_WaitMissionDone;
					}
				//所有转换已完成，跳转到完成阶段
  			else ADCState=ADC_ConvertComplete;		
			  break;	
			//提交线程任务后等待本次任务完成
      case ADC_WaitMissionDone:
          if(!ADC_ReadBackResult(&result,&Ch))break; //尝试读取结果，转换未完成则继续
			    ADC_WriteOutputBuf(result,Ch);
			    for(i=0;i<ADCConvertQueueDepth;i++)if(ADCConvertQueue[i]==Ch)ADCConvertQueue[i]=-2; //将当前已经完成转换的任务通道设置为-2标记转换完毕
			    ADCState=ADC_SubmitChFromQueue; //重新回到提交任务的阶段
			    break;
			//所有任务已完成
			case ADC_ConvertComplete:break;
			//其余任何非法状态跳转到初始阶段
			default:ADCState=ADC_SubmitQueue;
			}
		}
	while(IsNotAllowAsync&&ADCState!=ADC_ConvertComplete);
	}	
	
/**********************************************************************
以下函数为ADC异步转换引擎以及ADC的初始化和除能操作和驱动引擎获取外部通
道的电压数据所需的外部函数调用。您可以在初始化阶段和主函数内调用以下区
域的函数对ADC进行初始化和除能操作，以及启动引擎对ADC进行异步采样。
**********************************************************************/	
ADCResultStrDef Data;	 //ADC结果输出
	
//进行数据获取	
void SystemTelemHandler(void)
	{
  //调用ADC异步引擎
	ADCEngineHandler();
	}	
	
//关闭ADC
void ADC_DeInit(void)
	{
	GPIOCfgDef ADCDeInitCfg;
  char i;		
	//配置寄存器关闭ADC
	ADCON1=0x00; //关闭ADC
	ADCLDO=0x00; //关闭片内基准
	//清空队列并复位异步引擎
  IsNotAllowAsync=1;		
	ADCState=ADC_SubmitQueue;
	for(i=0;i<ADCConvertQueueDepth;i++)ADCConvertQueue[i]=-2;	
	ADCTemp.avgbuf=0;
	ADCTemp.Count=0;
	ADCTemp.Ch=0;
	ADCTemp.IsMissionProcessing=false;	
	//将需要禁用的ADC输入GPIO设置为普通GPIO模式
	GPIO_SetMUXMode(VOUTFBIOG,VOUTFBIOx,GPIO_AF_GPIO);
	GPIO_SetMUXMode(VBATInputIOG,VBATInputIOx,GPIO_AF_GPIO);
	//将需要禁用的ADC输入设置为推挽输出
	ADCDeInitCfg.Mode=GPIO_Out_PP;
  ADCDeInitCfg.Slew=GPIO_Slow_Slew;		
	ADCDeInitCfg.DRVCurrent=GPIO_Low_Current; //配置为低电流推挽输出
	
  GPIO_ConfigGPIOMode(VOUTFBIOG,GPIOMask(VOUTFBIOG),&ADCDeInitCfg); 
	GPIO_ConfigGPIOMode(VBATInputIOG,GPIOMask(VBATInputIOx),&ADCDeInitCfg); 
	//将需要禁用的ADC输入GPIO全部输出0
  GPIO_WriteBit(VBATInputIOG,VBATInputIOx,0);
	GPIO_WriteBit(VOUTFBIOG,VOUTFBIOx,0);
	//令NTC偏压供电输出=0关闭NTC和Strap电源
	GPIO_WriteBit(NTCENIOG,NTCENIOx,0); 
	}

//ADC初始化
void ADC_Init(void)
	{
	GPIOCfgDef ADCInitCfg;
	//初始化GPIO
	ADCInitCfg.Mode=GPIO_Input_Floating;
  ADCInitCfg.Slew=GPIO_Slow_Slew;		
	ADCInitCfg.DRVCurrent=GPIO_Low_Current; //配置为浮空输入	

	GPIO_ConfigGPIOMode(BATTSELIOG,GPIOMask(BATTSELIOx),&ADCInitCfg); 
  GPIO_ConfigGPIOMode(VOUTFBIOG,GPIOMask(VOUTFBIOG),&ADCInitCfg); 
	GPIO_ConfigGPIOMode(VBATInputIOG,GPIOMask(VBATInputIOx),&ADCInitCfg); 
	GPIO_ConfigGPIOMode(NTCInputIOG,GPIOMask(NTCInputIOx),&ADCInitCfg); 	//将对应的IO设置为指定的模式
	//初始化运放输出反馈
 	ADCInitCfg.Mode=GPIO_IPD;	
	GPIO_ConfigGPIOMode(OPFBIOG,GPIOMask(OPFBIOx),&ADCInitCfg); //运放输出给一个32K的下拉阻抗避免虚电
	
	GPIO_SetMUXMode(OPFBIOG,OPFBIOx,GPIO_AF_Analog);
	GPIO_SetMUXMode(BATTSELIOG,BATTSELIOx,GPIO_AF_Analog);
  GPIO_SetMUXMode(NTCInputIOG,NTCInputIOx,GPIO_AF_Analog);
	GPIO_SetMUXMode(VOUTFBIOG,VOUTFBIOx,GPIO_AF_Analog);
	GPIO_SetMUXMode(VBATInputIOG,VBATInputIOx,GPIO_AF_Analog); //将GPIO复用设置为模拟输入
	//配置并打开NTC分压电阻的供电
	ADCInitCfg.Mode=GPIO_Out_PP;
	ADCInitCfg.DRVCurrent=GPIO_High_Current; 	 //大电流推挽输出
		
	GPIO_SetMUXMode(NTCENIOG,NTCENIOx,GPIO_AF_GPIO);
  GPIO_ConfigGPIOMode(NTCENIOG,GPIOMask(NTCENIOx),&ADCInitCfg);		
  GPIO_WriteBit(NTCENIOG,NTCENIOx,1); //令供电输出=1打开NTC电源
	//配置ADC
	ADCON0=0x40; //AN31=内部1.2V基准，结果右对齐
	ADCON1=0x60; //Fadc=Fsys/128=375KHz
	ADCON2=0x00; //关闭ADC硬件触发功能，使用软件命令启动ADC
	ADCMPC=0x00; //关闭ADC比较器触发刹车功能
	ADDLYL=0x00; //将ADC硬件启动触发延时设置为0
	ADCMPH=0x0F;
	ADCMPL=0xFF; //ADC比较器默认值设置为0x0FFF
  ADCLDO=0xA0; //使能芯片内置ADC基准，输出2.0V
	//初始化异步ADC引擎
	ADCState=ADC_SubmitQueue;
	ADCTemp.avgbuf=0;
	ADCTemp.Count=0;
	ADCTemp.Ch=0;
	ADCTemp.IsMissionProcessing=false;
	IsNotAllowAsync=true; //初始化时禁止异步功能	
	//ADC配置完毕，使能ADC模块
	ADC_EnableCmd(); 
	}	
