redstoner-35/Xtern-Ripper-Lite/Firmware/Logic/SpecialMode.c

#include "ModeControl.h"
#include "LEDMgmt.h"
#include "SideKey.h"
#include "BattDisplay.h"
#include "TempControl.h"
#include "SpecialMode.h"

//全局变量和外部声明
extern xdata char DisplayLockedTIM;
static xdata char ShowTacModeTIM;
bit IsDisplayLocked;
SpecialOperationDef SysMode; //系统模式

//进入退出锁定切换
static void EnterExitLock(void)
	{
	DisplayLockedTIM=8; //指示锁定状态切换
	SysMode=!SysMode?Operation_Locked:Operation_Normal;
	}
	
//进入退出战术切换
static void EnterExitTac(void)
	{
	DisplayLockedTIM=2; //指示战术切换
	SysMode=!SysMode?Operation_TacTurbo:Operation_Normal;
	}	

//开启到普通模式
void PowerToNormalMode(ModeIdxDef Mode)
	{
	if(Battery>2.9)SwitchToGear(IsRampEnabled?Mode_Ramp:Mode); //正常开启
	else if(Battery>2.7)SwitchToGear(Mode_Moon);	 //大于2.7V的时候只能开月光
	else LEDMode=LED_RedBlinkFifth; //电池电量严重不足，红色闪五次
	}
	
//进入极亮和爆闪的判断
void EnterTurboStrobe(char TKCount,char ClickCount)	
	{
	char Count=TKCount>ClickCount?TKCount:ClickCount;
	//双击极亮
	if(Count==2)
		{
		if(Battery>3.1)SwitchToGear(Mode_Turbo); //电池电量充足正常开启
		else PowerToNormalMode(LastMode);  //电池电池电量不足时双击进入普通模式
		}
	//三击爆闪
	if(Count==3)
		{
		if(Battery>2.7)SwitchToGear(Mode_Strobe);   //进入爆闪
		else LEDMode=LED_RedBlinkFifth; //电量不足五次闪烁提示
		}
	}
	
//特殊模式下回到特殊功能里面的切换
void LeaveSpecialMode(char TKCount,char ClickCount)	
	{
	char Count=TKCount>ClickCount?TKCount:ClickCount;
	if(Count==2&&!IsDisableTurbo)SwitchToGear(Mode_Turbo); //双击极亮
	if(Count==3)SwitchToGear(IsRampEnabled?Mode_Ramp:Mode_Low); //三击退回到普通模式
	}	

//显示战术模式启用
bit DisplayTacModeEnabled(void)
	{
	//计时器控制
	if(CurrentMode->ModeIdx!=Mode_OFF||SysMode<Operation_TacTurbo)ShowTacModeTIM=0;
	else //进行累加
		{
		ShowTacModeTIM++; //进行增加
		if(ShowTacModeTIM==14&&SysMode==Operation_TacStrobe)return 1; //战术爆闪模式激活，频闪2次
		else if(ShowTacModeTIM==16)
			{
			ShowTacModeTIM=0;
			return 1; //返回1打开显示
			}		
		}
	//其余状态返回0
	return 0;
	}	
	
//特殊功能切换	
void SpecialModeOperation(char Click)
	{
		//复位flag
	  IsDisplayLocked=0;
		//特殊操作模式切换
			switch(SysMode)
				{
				//普通模式
				case Operation_Normal:
					if(Click==5)EnterExitLock(); //进入锁定模式
				  if(Click==6)EnterExitTac(); //进入战术模式
					break;
				//锁定模式
				case Operation_Locked:
				   if(Click==5)EnterExitLock();
				   else if(getSideKeyHoldEvent())IsDisplayLocked=1;
				   else if(IsKeyEventOccurred())LEDMode=LED_RedBlinkFifth; //指示手电已被锁定
				   break;
				//战术模式
				case Operation_TacTurbo:
				case Operation_TacStrobe:
				  if(Click==6)EnterExitTac();
					if(Click==2) //切换模式
						{
						if(SysMode==Operation_TacTurbo)
							{
							SysMode=Operation_TacStrobe;
							LEDMode=LED_GreenBlinkThird; //开启爆闪战术
							}
						else
							{
							SysMode=Operation_TacTurbo;
							LEDMode=LED_RedBlinkThird;  //关闭爆闪战术
							}
						}
					if(getSideKeyHoldEvent())EnterTurboStrobe(SysMode==Operation_TacStrobe?3:2,0); //调用进入函数尝试进极亮
			  break;
				}
	}	
