redstoner-35/Xtern-Ripper-Lite/(commit log)

2024-11-09 修复Readme无法查看部分图片的问题 更新Readme中电量指示的内容
2024-11-09 删除无用的文件 更新PDF格式的原理图
    [Xtern-Ripper Lite.PrjPcb]
2024-11-10 增加侧按LED指示灯的亮度调整功能 更新readme中关于月光亮度调整和电量查询的章节 修改固件出厂时的月光挡位配置为10mA挡位
    [BattVoltDisplay.obj, LEDMgmt.obj, ModeControl.obj, PWM.obj, RampConfig.obj, SelfTest.obj, Sleep.obj, TempControl.obj]
2024-11-11 更新驱动的硬件版本号至V1.1新增串数选择的硬件strap 更新驱动的固件程序解决按键操作不灵敏的bug 更新驱动的固件程序以支持V1.1硬件锁增加的串数选择strap 更新readme附加串数选择和显示的相关内容 移除PCB工程内不需要的垃圾文件
    [ADCCfg.obj, BOM.xlsx, BattVoltDisplay.obj, LEDMgmt.obj, ModeControl.obj, OutputChannel.obj, PCB1.PcbDoc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]
2024-11-15 更新固件分支，支持双模式换挡功能兼容东东海D5E双开关壳子 修复固件内温度控制部分比例项无法回升的bug 进行了部分代码的结构优化 更新readme关于新增的尾按换挡功能的介绍
    [ADCCfg.obj, BattVoltDisplay.obj, Flash.obj, LEDMgmt.obj, ModeControl.obj, NTC.obj, OutputChannel.obj, PWM.obj]
2024-11-16 移除掉不需要的文件 开启比较器的刹车中断禁用PWM，延长尾按模式下的掉电保护时间
    [ADCCfg.obj, BattVoltDisplay.obj, Flash.obj, LEDMgmt.obj, ModeControl.obj, NTC.obj, OutputChannel.obj, PWM.obj]
2024-11-16 移除固件工程内非必要的代码
2024-11-20 修复双模式固件在纯侧按使用时意外触发尾按动作的bug 修复双模式固件中尾按部分SOS挡位按下尾按关机后无法回到低亮的bug 对BOM文件进行调整增加单击和总价信息
    [BOM.xlsx]
2024-11-21 修复在SOS模式下，手电熄灭过程中尾按开关无法换挡的bug 更新readme添加在爆闪模式下单击循环切换爆闪和SOS之间转换的描述
2024-11-21 增加尾按操作时切换无极调光和挡位模式的功能。 增加尾按操作时进入月光档的功能 调大PWMDAC的setup延迟优化月光档开启前闪烁的问题
2024-11-24 移除旧版的纯侧按版本固件，仅保留最新的固件源代码。 更新V1.1版本硬件，增加配置识别电阻实现无需刷固件的用户SKU设置LED类型等硬件参数。 移除用户基本不会使用的月光挡位配置功能。 更改硬件参数提高月光档的使用体验。
    [BOM.xlsx, PCB1.PcbDoc, Xtern-Ripper Lite.PrjPcb, main.SchDoc]
2024-11-24 更新Readme修正已被移除的目录以及逻辑图片
2024-11-26 更新硬件部分的内电层走线优化性能 增加输出电容容量提升低电流下的稳定性
    [BOM.xlsx, Xtern-Ripper Lite.PrjPcb, main.SchDoc]
2024-11-26 更新原理图中主检流电阻的型号至BVT-V-R002-1.0
    [BOM.xlsx, Xtern-Ripper Lite.PrjPcb, main.SchDoc]
2024-11-29 增加尾按正向和反向机械开关的Strap选择支持正向战术点射开关 增加驱动过压保护机制以免用户错误选择电池节数时过放电保护失效而导致电池损坏 更新驱动的Strap识别机制优化代码占用 优化无极调光配置存储的CRC校验函数提高效率。
2024-12-06 版本1.1.0.0大幅度更新，详细请查看ChangeLog 增加ChangeLog用于记录版本更新内容
    [BOM.xlsx, main.SchDoc]
2024-12-12 1.1.0.1版本更新，详情请查看ChangeLog
    [BOM.xlsx, main.SchDoc]
2024-12-15 V1.1.0.2版本更新，详情请参考ChangeLog
2024-12-15 V1.1.0.3版本更新，详情请查看ChangeLog
2024-12-22 V1.1.0.4更新，详情请查看ChangeLog
2024-12-29 V1.1.0.5版本更新，详情请查阅ChangeLog
